EyalYe/unicorne-zmk-config/docs/unicorne-matrix.png

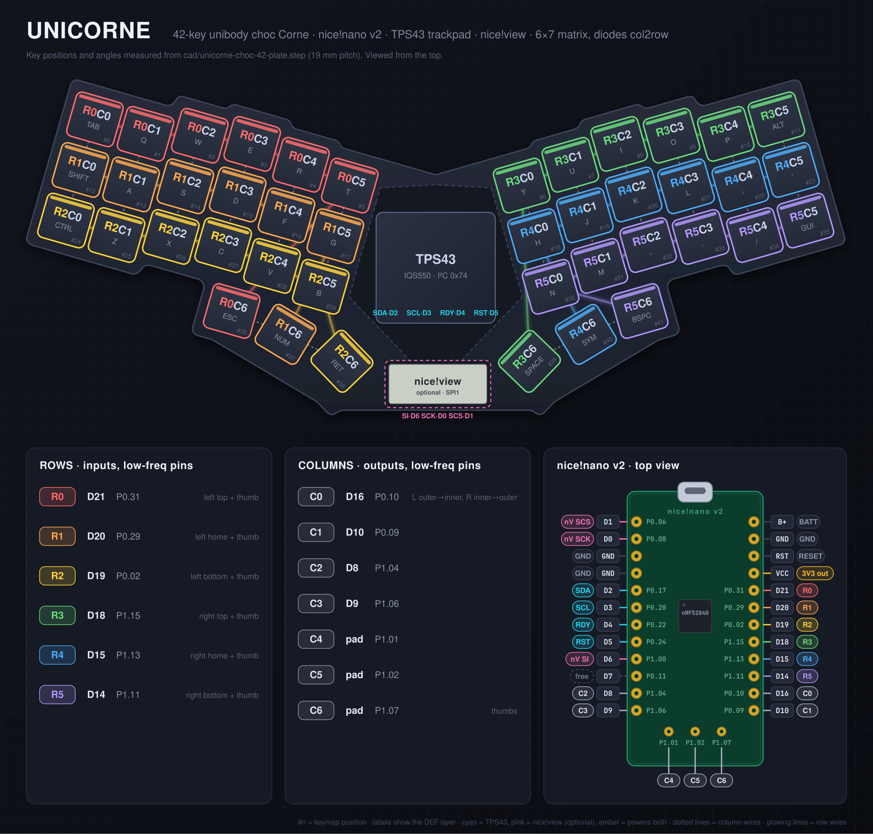
docs/unicorne-matrix.png
