EyalYe/unicorne-zmk-config/cad/unicorne-choc-42-plate.step

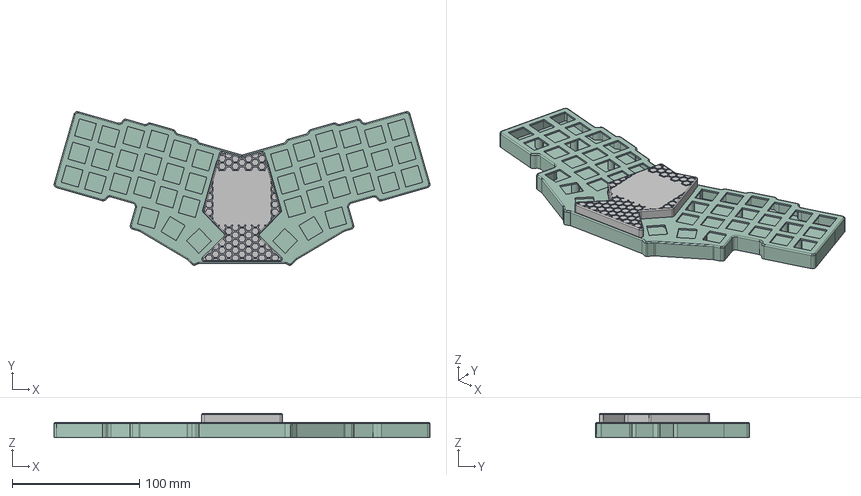
[picture p2: CAD file, 2026-10-28]
cad/unicorne-choc-42-plate.step
295.4 x 120.8 x 19.2 mm
