EyalYe/unicorne-zmk-config/(commit log)

2026-10-28 Add Unicorne ZMK config: 42-key unibody choc Corne with TPS43 trackpad
    - nice!nano v2 shield with 6x7 matrix on low-frequency pins
    - TPS43 on fast pins via AYM1607/zmk-driver-azoteq-iqs5xx
    - Physical layout measured from the 3MF model (ZMK Studio + keymap-editor)
    - Keymap ported from tbk_nini
    - GitHub Actions build
2026-10-28 Trim keymap to 6 layers, add wiring diagram and STEP source
    - Remove GAME, GN, ONEHAND, ONEHAND2 layers and the combos/macro that
    only served them; renumber SCRL/SNYP
    - Add docs/unicorne-matrix.{svg,png} showing every key's row/col, wires
    and the nice!nano pinout
    - Add cad/unicorne-choc-42-plate.step as the layout source of truth
    - Document nice!view pin availability
    [unicorne-choc-42-plate.step]
2026-10-28 Redraw nice!nano v2 pinout in wiring diagram
2026-10-28 Update STEP: nice!view trackpad mount, moved center screw
    - New track_pad_pad_nice_view body with a 34.9x14.2 mm display window
    - Center screw and boss moved 5.7 mm toward the trackpad
    - Switch plate unchanged, so key layout is unchanged
    - Diagram shows the nice!view window
    [unicorne-choc-42-plate.step]
2026-10-28 Label nice!view pins as SI/SCS to match its silkscreen
2026-10-28 Update STEP: nice!view mounted rotated 180° in its window
    Only track_pad_pad_nice_view changed (window recentred to x=177.45,
    35.3 mm wide). Firmware unchanged.
    [unicorne-choc-42-plate.step]
